allcallday/CS493_Autonomous_Robot_Car/CMPE 492 - Senior Design 1/Block Diagram.pptx

V REGULATOR 3.3 V

5V

Oscillator

PWMx2

Rst Button

SCL

Lvl Shifter

CPU

Analog (to ADC)

SDA

DC
motor

+

Imu

IR Sensor

Serial TXD

H-BRIDGE

Analog (to ADC)

LCD Toggle Button

Analog (to ADC)

IR Sensor

IR Sensor

ULTRASONIC
SENSOR x2

DC
motor

+

5V

V REGULATOR 5V

LCD CHARACTER DISPLAY

Trig

Echo
