allcallday/CS493_Autonomous_Robot_Car/Meeting Notes/MeetingNotes 4_10_2020.docx

4/10/2020

Meeting Notes

4/10/2020 Fri. 13:05

- meeting w/ prof.
- opening a serial port on Beaglebone
  - blah
- IR sensor testing considerations
  - know your ADC
    - does your microprocessor have one built in?
    - what’s the bit resolution?
    - how many separate analog signals can it convert at a time?
    - if your processor’s ADC has different specs than someone else’s, you will probably have different results and driver implementations
