allcallday/CS493_Autonomous_Robot_Car/Meeting Notes/MeetingNotes 4_24_2020.docx

4/24/2020

CMPE 493

Meeting Notes

4/24/2020 Fri. 13:00

- regular weekly meeting w/ prof.
- Group member progress:
  - Christian
    - got LCD module to work
  - Abdullah
    - modified PCB for further testing
    - may have found a way to use the custom PCB without having to remove the Atmel UC3C
  - Eric
    - got ultrasonic distance sensors working
    - IMU prep
      - Arduino uno needs level shifter hardware to communicate w/ IMU
      - began soldering connections to level shifter on PCB
- start bringing the peripherals together into a full system
