allcallday/CS493_Autonomous_Robot_Car/CMPE 492 - Senior Design 1/CPU Pin Connections.xlsx

TQFP 64. Pin Num. | Pin Name | Pin Function |  |  |  |  |  | Connected to Device: | Description
 |  | A | B | C | D | E | F
1 | PA00 | - | CANIF - TXLINE[1] | - | - | - | - | JTAG - TCK
2 | PA01 | - | CANIF - RXLINE[1] | PEVC - PAD_EVT[0] | - | - | - | JTAG - TDI
3 | PA02 | SCIF - GCLK[0] | - | PEVC - PAD_EVT[1] | - | - | - | JTAG - TDO
4 | PA03 | SCIF - GCLK[1] | EIC - EXTINT[1] | - | - | - | - | JTAG - TMS
5 | VDDIO1 | - | - | - | - | - | - | VDD_5
6 | GNDIO1 | - | - | - | - | - | - | GND
7 | PA04 | ADCIN0 | USBC - ID | ACIFA0 - ACAOUT | - | - | - | IR_1 - Col. | -
8 | PA05 | ADCIN1 | USBC - VBOP | ACIFA0 - ACBOUT | - | - | - | IR_2 - Col. | -
9 | PA06 | ADCIN2 | AC1AP1 | PEVC - PAD_EVT[2] | - | - | - | IR_3 - Col. | -
10 | PA07 | ADCIN3 | AC1AN1 | PEVC - PAD_EVT[3] | - | - | -
11 | PA08 | ADCIN4 | AC1BP1 | EIC - EXTINT[2] | - | - | - | GPIO - Button 1 | Toggle LCD
12 | PA09 | ADCIN5 | AC1BN1 | - | - | - | - | GPIO - Button 2 | Begin Log Export
13 | PA16 | ADCREF0 | - | DACREF | - | - | -
14 | ADCVREFP | - | - | - | - | - | - | VDD_5
15 | ADCVREFN | - | - | - | - | - | - | GND
16 | PA19 | ADCIN8 | EIC - EXTINT[1] | - | - | - | - | GND
17 | GNDANA | - | - | - | - | - | - | GND
18 | VDDANA | - | - | - | - | - | - | VDD_5
19 | PA20 | ADCIN9 | AC0AP0 |  | - | - | - | GND
20 | PA21 | ADCIN10 | AC0BN0 |  | - | - | - | GND
21 | PA22 | ADCIN11 | AC0AN0 |  | - | MACB - SPEED | -
22 | PA23 | ADCIN12 | AC0BP0 |  | - | MACB - WOL | -
23 | VBUS | - | - | - | - | - | - | NC
24 | DM | - | - | - | - | - | - | NC
25 | DP | - | - | - | - | - | - | NC
26 | GNDPLL | - | - | - | - | - | - | GND
27 | VDDIN_5 | - | - | - | - | - | - | VDD_5
28 | VDDIN_33 | - | - | - | - | - | - | NC
29 | VDDCORE | - | - | - | - | - | - | NC
30 | GNDCORE | - | - | - | - | - | - | GND
31 | PB30 | - | - | - | - | - | - | Crystal
32 | PB31 | - | - | - | - | - | - | Crystal
33 | PC02 | TWIMS0 - TWD | SPI0 - SPCS[3] | USART2 - RXD | TC1 - CLK1 | MACB - MDC |  | Lvl Shifter HV1 - IMU clk
34 | PC03 | TWIMS0 - TWCK | EIC - EXTINT[1] | USART2 - TXD | TC1 - B1 | MACB - MDIO |  | Lvl Shifter HV2 - IMU data
35 | VDDIO2 | - | - | - | - | - | - | VDD_5
36 | GNDIO2 | - | - | - | - | - | - | GND
37 | PC04 | TWIMS1 - TWD | EIC - EXTINT[3] | USART2 - TXD | TC0 - B1 | - | -
38 | PC05 | TWIMS1 - TWCK | EIC - EXTINT[4] | USART2 - RXD | TC0 - B2 | - | -
39 | PC15 | PWM - PWMH[1] | SPI0 - NPCS[0] | EBI - SDWE | USART0 - RXD | CANIF - RXLINE[1] | - | L293DD - En1
40 | PC16 | PWM - PWML[1] | SPI0 - NPCS[1] | EBI - CAS | USART0 - TXD | CANIF - TXLINE[1] | - | GPIO - L293DD - In1
41 | PC17 | PWM - PWMH[0] | SPI0 - NPCS[2] | EBI - RAS | IISC - ISDO | - | USART3 - TXD | GPIO - L293DD - In2
42 | PC18 | PWM - PWML[0] | EIC - EXTINT[5] | EBI - SDA10 | IISC - ISDI | - | USART3 - RXD | GPIO - L293DD - In3
43 | PC19 | PWM - PWML[2] | SCIF - GCLK[0] | EBI - DATA[0] | IISC - IMCK | - | USART3 - CTS | GPIO - L293DD - In4
44 | PC20 | PWM - PWMH[2] | SCIF - GCLK[1] | EBI - DATA[1] | IISC - ISCK | - | USART3 - RTS | L293DD - En2
45 | PC21 | PWM - EXT_FAULTS[0] | CANIF - RXLINE[0] | EBI - DATA[2] | IISC - IWS | - | -
46 | PC22 | PWM - EXT_FAULTS[1] | CANIF - TXLINE[0] | EBI - DATA[3] | - | USART3 - CLK | - | GPIO - Ultrasonic - EchoL
47 | PD00 | SPI0 - MOSI | TC1 - CLK0 | EBI - DATA[13] | QDEC0 - QEPI | USART0 - TXD | - | GPIO - Ultrasonic - EchoR
48 | PD01 | SPI0 - MISO | TC1 - A0 | EBI - DATA[14] | TC0 - CLK1 | USART0 - RXD | - | GPIO - Ultrasonic - Trig
49 | PD02 | SPI0 - SCK | TC0 - CLK2 | EBI - DATA[15] | QDEC0 - QEPA | - | -
50 | PD03 | SPI0 - NPCS[0] | TC0 - B2 | EBI - ADDR[0] | QDEC0 - QEPB | - | -
51 | VDDIO3 | - | - | - | - | - | - | VDD_5
52 | GNDIO3 | - | - | - | - | - | - | GND
53 | PD11 | USART1 - TXD | USBC - ID | EBI - ADDR[8] | PEVC - PAD_EVT[6] | MACB - TXD[0] | - | LogOut - TXD
54 | PD12 | USART1 - RXD | USBC - VBOF | EBI - ADDR[9] | PEVC - PAD_EVT[7] | MACB - TXD[1] | - | LogOut - RXD
55 | PD13 | USART1 - CTS | USART1 - CLK | EBI - SDCK | PEVC -PAD_EVT[8] | MACB - RXD[0] | - | LogOut - CTS
56 | PD14 | USART1 - RTS | EIC - EXTINT[7] | EBI - ADDR[10] | REVD - PAD_EVT [9] | MACB - RXD[1] | - | LogOut - RTS
57 | PD21 | USART3 - TXD | EIC - EXTINT[0] | EBI - ADDR[17] | QDEC1 - QEPA | - | - | LCD - Rx
58 | PD27 | USART0 - TXD | CANIF - RXLINE[0] | EBI - NCS[1] | TC0 - A0 | MACB - RX_ER | -
59 | PD28 | USART0 - RXD | CANIF - TXLINE[0] | EBI - NCS[2] | TC0 - A0 | MACB - RX_DV | -
60 | PD29 | USART0 - CTS | EIC - EXTINT[6] | USART0 - CLK | TC0 - CLK0 | MACB - TX_CLK | -
61 | PD30 | USART0 - RTS | EIC - EXTINT[3] | EBI - NWAIT | TC0 - A1 | MACB - TX_EN | -
62 | PB00 | USART0 - CLK | CANIF - RXLINE[1] | EIC - EXTINT[8] | PEVC - PAD_EVT[10] | - | -
63 | PB01 | - | CANIF - TXLINE[1] | - | PEVC - PAD_EVT[11] | - | -
64 | RESET_N | - | - | - | - | - | -
 |  |  |  |  | .
Disabled Connections: | Occupied Connections: | Free GPIO pins (14):
 | TWIMS0 | PA7
 | PWMH[1] | PA16
 | PWMH[2] | PA22
 | USART1 | PA23
 | USART3 | PC04
 |  | PC05
 |  | PC21
