allcallday/CS493_Autonomous_Robot_Car/CMPE 492 - Senior Design 1/Senior Design Group Meeting Schedule.xlsx

Senior Design Group Meeting Schedule |  |  |  | Online meeting | In-person meeting
Regular Meetings
Time | Mon. | Tue. | Wed. | Thurs. | Fri. | Sat. | Sun. | * [EF]: I have a phone appointment at 2:30pm on Tue. 11/5
8:00:00
9:00:00
10:00:00 |  | [AW] |  | [AW]
11:00:00 |  | [AW] |  | [AW] |  | [EF] [AW] [CA]
12:00:00 | [EF] | [AW] | [EF] | [AW] |  | [EF] [AW] [CA]
13:00:00 | [EF] | [EF] [AW] [CA] | [EF] | [EF] [AW] |  | [EF] [AW] [CA]
14:00:00 | [EF] [AW] [CA] | [EF] [AW] [CA] | [EF] [AW] [CA] | [EF] [AW] |  | [EF] [AW] [CA]
15:00:00 | [EF] [AW] [CA] | [EF] [AW] [CA] | [EF] [AW] [CA] | [EF] [AW] | [AW] | [EF] [AW] [CA]
16:00:00 | [EF] | [AW] | [EF] | [AW] | [AW] | [EF] [AW] [CA]
17:00:00 | [EF] | [AW] | [EF] | [AW] | [AW]
18:00:00 | [EF] | [AW] | [EF] | [AW] | [AW]
19:00:00 | [EF] | [EF] [AW] | [EF] | [EF] [AW] | [AW]
20:00:00 | [EF] | [EF] [AW] | [EF] | [EF] [AW] | [AW]
21:00:00
22:00:00
23:00:00
Nonregular Meetings
Date | Day | Time | Place
2019-11-02 | Sat. | 11:00:00 | SciN 237
