allcallday/CS493_Autonomous_Robot_Car/CMPE 492 - Senior Design 1/BoM/BoM-OtherMaterials.xlsx

IR Bumper BoM
Item # | *Ref Des | *Qty | Manufacturer | *Mfg Part # | Description / Value | *Package | Type | Your Instructions / Notes | Unit Cost | Total Cost | Website
1 | JP1 | 1 | Sullins Connector Solutions |  | Pin Header Male 5x1 0.1 inch | 1x05 | Thru-hole | -
2 | R1 | 1 | Yageo | RC0805JR-07100RL | Resistor 100Ohm | M0805 | SMD | - | 0.10000 | $0.10 | https://www.digikey.com/product-detail/en/yageo/RC0805JR-07100RL/311-100ARCT-ND/731185
3 | R2,R3,R4 | 10 | Yageo | RC0805FR-0710KL | Resistor 10KOhm | M0805 | SMD | - | 0.04000 | $0.40 | https://www.digikey.com/product-detail/en/yageo/RC0805FR-0710KL/311-10.0KCRCT-ND/730482
4 | U1,U2,U3 | 10 | ON Semiconductor | QRE1113GR | IR Reflective Sensor | 4-SMD | SMD | - | 0.84500 | $8.45 | https://www.digikey.com/product-detail/en/on-semiconductor/QRE1113GR/QRE1113GRCT-ND/965713
 |  |  |  |  |  |  |  |  |  | $8.95
Offboard Modules BoM
Item # | *Ref Des | *Qty | Manufacturer | *Mfg Part # | Description / Value | *Package | Type | Your Instructions / Notes | Unit Cost | Total Cost | Website
1 | - | 2 | Sparkfun Electronics | SEN-15569 | Ultrasonic Proximity Sensor | N/A | - | - | 3.95000 | $7.90 | https://www.digikey.com/products/en?keywords=SEN-15569
2 | - | 1 | Adafruit Industries LLC | 782 | LCD Module | N/A | - | - | 24.95000 | $24.95 | https://www.digikey.com/product-detail/en/adafruit-industries-llc/782/1528-2051-ND/5761275
3 | - | 5 | NMB Technologies Corporation | M1N10FB11G | DC Brushed Motor | N/A | - | - | 3.07800 | $15.39 | https://www.digikey.com/product-detail/en/nmb-technologies-corporation/M1N10FB11G/P14354-ND/2417078
4 | - | 1 | Microchip Technology | ATATMEL-ICE-BASIC | ATMEL ICE Basic Programmer | N/A | - | - | 90.89000 | $90.89 | https://www.digikey.com/product-detail/en/microchip-technology/ATATMEL-ICE-BASIC/ATATMEL-ICE-BASIC-ND/4753381
5 | - | 1 | Sabrent |  | USB to Serial Cable | N/A | - | - | 8.99000 | $8.99 | https://www.amazon.com/Sabrent-Converter-Prolific-Chipset-CB-DB9P/dp/B00IDSM6BW
6 | - | 1 | Bonatech |  | 2-wheel car chassis | N/A | - | - | 17.89000 | $17.89 | https://www.amazon.com/BONATECH-Tracking-Obstacle-Avoidance-Detailed/dp/B07DMCWRJ1
7 | - | 1 | LampVPath |  | 4-slot AA battery Holder | N/A | - | - | 5.99000 | $5.99 | https://www.amazon.com/LAMPVPATH-Battery-Holder-Leads-Wires/dp/B07T7MTRZX
8 | - | 1 | STIKK |  | Blue Painter Tape | N/A | - | - | 8.97000 | $8.97 | https://www.amazon.com/STIKK-Painters-Release-Finishing-Masking/dp/B01MYP8R5B
 |  |  |  |  |  |  |  |  | total | $180.97
