allcallday/CS493_Autonomous_Robot_Car/CMPE 492 - Senior Design 1/Milestone Submissions/Milestone 3 - Bill of Materials.xlsx

Quantity: | Manufacturer: | Part Number: | URL: | Unit Price: | Ext. Price: | Description: | Power Requirements: | Digikey Part No.: | Datasheet: | Connectivity: | Has EAGLE Part:
1 | Microchip Technology | ATATMEL-ICE-BASIC | https://www.digikey.com/product-detail/en/microchip-technology/ATATMEL-ICE-BASIC/ATATMEL-ICE-BASIC-ND/4753381 | 90.88900 | $90.89 | Atmel-ICE basic JTAG programmer | N/A | ATATMEL-ICE-BASIC-ND | http://ww1.microchip.com/downloads/en/DeviceDoc/Atmel-ICE_UserGuide.pdf | 2x5 50-mil male pin header | N/A | $209.93
5 | NMB Technologies Corporation | M1N10FB11G | https://www.digikey.com/product-detail/en/nmb-technologies-corporation/M1N10FB11G/P14354-ND/2417078 | 3.25000 | $15.54 | DC brushless motor | 5V DC | P14354-ND | https://media.digikey.com/pdf/Data%20Sheets/NMB-MAT/M1N10.pdf | N/A | Represent w/ pads
2 | SparkFun Electronics | SEN-15569 | https://www.digikey.com/products/en?keywords=SEN-15569 | 3.95000 | $7.90 | Ultrasonic distance sensor | 5V | 1568-SEN-15569-ND | https://cdn.sparkfun.com/datasheets/Sensors/Proximity/HCSR04.pdf | Trig-Echo - 2 | Y
10 | ON Semiconductor | QRE1113GR | https://www.digikey.com/product-detail/en/on-semiconductor/QRE1113GR/QRE1113GRCT-ND/965713 | 1.09000 | $8.45 | IR reflective sensor | 5 V | QRE1113GRCT-ND | https://www.onsemi.com/pub/Collateral/QRE1113-D.PDF | Analog - 3 | Y
1 | STMicroelectronics | L293DD | https://www.digikey.com/product-detail/en/stmicroelectronics/L293DD/497-1390-5-ND/585913 | 3.91000 | $3.91 | H-bridge (surface mount) | 4.5V - 36V | 497-1390-5-ND | https://www.st.com/content/ccc/resource/technical/document/datasheet/04/ac/22/f9/20/5d/43/a1/CD00000059.pdf/files/CD00000059.pdf/jcr:content/translations/en.C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 | PWM - 1 | Y
10 | C&K | PTS645SM43SMTR92 LFS | https://www.digikey.com/product-detail/en/c-k/PTS645SM43SMTR92-LFS/CKN9112CT-ND/1146934 | 0.31000 | $3.00 | push buttons | N/A | CKN9112CT-ND | https://www.digikey.com/en/datasheets/ck/ckpts645 | N/A | Y
10 | Diodes Incorporated | AP2210K-5.0TRG1 | https://www.digikey.com/product-detail/en/diodes-incorporated/AP2210K-5.0TRG1/AP2210K-5.0TRG1DICT-ND/4505292 | 0.42000 | $3.49 | voltage regulators (output 5V) | max: 13.2V | AP2210K-5.0TRG1DICT-ND | https://www.diodes.com/assets/Datasheets/AP2210.pdf | N/A | Y
1 | Microchip Technologies | AT32UC3C2512C-A2UT | https://www.digikey.com/product-detail/en/microchip-technology/AT32UC3C2512C-A2UT/AT32UC3C2512C-A2UT-ND/2507920 | 10.64000 | $10.64 | 32-bit AVR CPU | 3V ~ 5.5V | AT32UC3C2512C-A2UT-ND | http://ww1.microchip.com/downloads/en/DeviceDoc/doc32117.pdf | PWM - 1, USART - 5, SPI - 2, I2C - 3 | Y
1 | Adafruit Industries LLC | 782 | https://www.digikey.com/product-detail/en/adafruit-industries-llc/782/1528-2051-ND/5761275 | 24.95000 | $24.95 | LCD Character display | 5V | 1528-2051-ND | https://cdn-learn.adafruit.com/downloads/pdf/usb-plus-serial-backpack.pdf | Serial | Y
1 | SparkFun Electronics | SEN-13762 | https://www.digikey.com/product-detail/en/sparkfun-electronics/SEN-13762/1568-1420-ND/6166011 | 14.95000 | $14.95 | imu module for accelerometer | 2.4V ~ 3.6V | 1568-1420-ND | https://www.invensense.com/wp-content/uploads/2015/02/MPU-9250-Datasheet.pdf | I2C - 1 | Y
1 | IQD Frequency Products | LFXTAL003210BULK | https://www.digikey.com/product-detail/en/iqd-frequency-products/LFXTAL003210BULK/1923-1459-ND/8633747 | 0.59000 | $0.59 | 12 MHz crystal oscillator | N/A | 1923-1459-ND | https://www.iqdfrequencyproducts.com/products/pn/LFXTAL003210Bulk.pdf | N/A | Y
10 | Diodes Incorporated | AP2210K-3.3TRG1 | https://www.digikey.com/product-detail/en/diodes-incorporated/AP2210K-3.3TRG1/AP2210K-3.3TRG1DICT-ND/4505291 | 0.31000 | $3.10 | voltage regulator 3.3V | max: 13.2 V | AP2210K-5.0TRG1DICT-ND | https://www.diodes.com/assets/Datasheets/AP2210.pdf | N/A | Y
10 orders, 23 pins total | Adam Tech | PH1-04-UA | https://www.digikey.com/product-detail/en/adam-tech/PH1-04-UA/2057-PH1-04-UA-ND/9829296 | 0.07300 | $0.73 | male 4-pin header (UART - 2, motors - 4, ultrasonics - 8, IRs - 7, IMU - 4, LCDDisplay - ?, JTAG interface) | N/A | 2057-PH1-04-UA-ND | http://adam-tech.com/downloader.php?p=PH1-XX-UA.pdf | N/A | Generics in EAGLE
10 | Sullins Connector Solutions | NPPN041BFLC-RC | https://www.digikey.com/product-detail/en/sullins-connector-solutions/NPPN041BFLC-RC/S5901-04-ND/807246 | 0.66000 | $6.68 | 4x1 rectangular female header | N/A | S5901-04-ND | https://drawings-pdf.s3.amazonaws.com/10489.pdf | N/A | Generics in EAGLE
10 | Sullins Connector Solutions | NPPN051BFLD-RC | https://www.digikey.com/product-detail/en/sullins-connector-solutions/NPPN051BFLD-RC/S5902-05-ND/810021 | 0.78000 | $7.80 | 5x1 rectangular female header | N/A | S5902-05-ND | https://drawings-pdf.s3.amazonaws.com/10489.pdf | N/A | Generics in EAGLE
1 | Sullins Connector Solutions | GRPB052VWQP-RC | https://www.digikey.com/product-detail/en/sullins-connector-solutions/GRPB052VWQP-RC/S9013E-05-ND/1786428 | 1.05000 | $1.05 | 2x5 male pin header (1.27mm spacing) for jtag SMD | N/A | 609-3695-1-ND | https://s3.amazonaws.com/catalogspreads-pdf/PAGE94-95%20.050%20MALE%20HDR%20ST%20RA%20SMT.pdf |  | Y
10 | ON Semiconductor | BSS138 | https://www.digikey.com/product-detail/en/on-semiconductor/BSS138/BSS138CT-ND/244294 | 0.22000 | $2.20 | N-channel MOSFET for level shifting | source-gate: 3.3V, drain: 5V | BSS138CT-ND | https://www.onsemi.com/pub/Collateral/BSS138-D.PDF | N/A | Y
1 | Nidec Copal Electronics | AS1E-2M-10-Z | https://www.digikey.com/product-detail/en/nidec-copal-electronics/AS1E-2M-10-Z/563-1582-ND/1792120 | 2.27000 | $2.27 | slide switch for power |  | 563-1582-ND | https://www.nidec-copal-electronics.com/e/catalog/switch/as.pdf | N/A | Y
10 | Yageo | RC0805JR-07100RL | https://www.digikey.com/product-detail/en/yageo/RC0805JR-07100RL/311-100ARCT-ND/731185 | 0.03500 | $0.35 | 100 Ohm | 0.063W, 1/16W | 311-100ARCT-ND | https://www.yageo.com/upload/media/product/productsearch/datasheet/rchip/PYu-RC_Group_51_RoHS_L_10.pdf | N/A | Y
4 | Yageo | RC0805FR-0710KL | https://www.digikey.com/product-detail/en/yageo/RC0805FR-0710KL/311-10.0KCRCT-ND/730482 | 0.10000 | $0.40 | 10 KOhm |  | 311-10.0KCRCT-ND | https://www.yageo.com/upload/media/product/productsearch/datasheet/rchip/PYu-RC_Group_51_RoHS_L_10.pdf | -
2 | Kemet | C0805C101JAGAC7800 | https://www.digikey.com/product-detail/en/kemet/C0805C101JAGAC7800/399-15000-1-ND/7382549 | 0.93000 | $1.86 | 100 pF Capacitor |  | 399-15000-1-ND | https://content.kemet.com/datasheets/KEM_C1003_C0G_SMD.pdf | -
2 | Kemet | 399-4925-1-ND | https://www.digikey.com/product-detail/en/kemet/C0805C106K8PACTU/399-4925-1-ND/1090920 | 0.16000 | $0.32 | 10 uF Capacitor |  | 399-4925-1-ND | https://www.digikey.com/product-detail/en/kemet/C0805C106K8PACTU/399-4925-1-ND/1090920 | -
1 | Sabrent | DP9P-9P6F | https://www.amazon.com/Sabrent-Converter-Prolific-Chipset-CB-DB9P/dp/B00IDSM6BW | 8.99000 | $8.99 | USB to serial cable
1 | eBoot | EBOOT-BULBS-03 | https://www.amazon.com/eBoot-Pieces-Emitting-Diodes-Assorted/dp/B06XPV4CSH | 6.55000 | $6.55 | LEDs |  | N/A | N/A | N/A | Generics in EAGLE
1 | Bonatech | N/A | https://www.amazon.com/BONATECH-Tracking-Obstacle-Avoidance-Detailed/dp/B07DMCWRJ1 | 17.89000 | $17.89 | 2-wheel car chasis | N/A | N/A | N/A | N/A | N/A
1 | LAMPVPATH | 4AA-2PC | https://www.amazon.com/LAMPVPATH-Battery-Holder-Leads-Wires/dp/B07T7MTRZX | 5.99000 | $5.99 | (Pack of 2) 4 AA battery holder | 4 AA batteries = 6V | N/A | N/A | N/A | N/A
1 | STICK | N/A | https://www.amazon.com/STIKK-Painters-Release-Finishing-Masking/dp/B01MYP8R5B | 8.97000 | $8.97 | Blue Painter Tape | N/A | N/A | N/A | N/A | N/A
Old Parts:
~~1~~ | ~~SparkFun Electronics~~ | ~~PGM-09825 ~~ | ~~https://www.digikey.com/products/en?keywords=pocket%20avr%20programmer~~ |  | ~~$16.95~~ | ~~POCKET AVR PROGRAMMER~~ |  | ~~1568-1080-ND~~ | ~~https://media.digikey.com/pdf/Data%20Sheets/Sparkfun%20PDFs/Pocket_AVR_Prog_HookupGuide_Web.pdf~~ | ~~SPI~~
~~1~~ | ~~SparkFun Electronics~~ | ~~DEV-09215~~ | ~~https://www.digikey.com/product-detail/en/sparkfun-electronics/DEV-09215/1568-1361-ND/5973887~~ |  | ~~$1.95~~ | ~~AVR programming cable~~ |  | ~~1568-1361-ND~~ | ~~https://media.digikey.com/pdf/Data%20Sheets/Sparkfun%20PDFs/DEV-09215_Web.pdf~~ | ~~SPI~~
~~1~~ | ~~Microchip Technology~~ | ~~ATMEGA328P-AU~~ | ~~https://www.digikey.com/product-detail/en/microchip-technology/ATMEGA328P-AU/ATMEGA328P-AU-ND/1832260~~ |  | ~~$2.07~~ | ~~cpu~~ | ~~1.8V - 5.5V~~ | ~~ATMEGA328P-AU-ND~~ |  | ~~I²C, SPI, UART/USART~~
~~5~~ | ~~Kionix Inc.~~ | ~~KXTJ3-1057~~ | ~~https://www.digikey.com/product-detail/en/kionix-inc/KXTJ3-1057/KXTJ3-1057CT-ND/6573089~~ |  | ~~$8.14~~ | ~~accelerometer~~ | ~~1.71V –3.6V~~ |  |  | ~~I2C~~
~~1~~ | ~~Lumex Opto/Components Inc.~~ | ~~LCM-S01602DTR/M~~ | ~~https://www.digikey.com/product-detail/en/lumex-opto-components-inc/LCM-S01602DTR-M/67-1781-ND/469805~~ |  | ~~$9.65~~ | ~~LCD Character display~~ | ~~5V~~ | ~~67-1781-ND~~ |  | ~~parallel?~~
~~1~~ | ~~Newhaven Display Intl~~ | ~~NHD-C0216AZ-FSW-GBW-ND~~ | ~~https://www.digikey.com/product-detail/en/newhaven-display-intl/NHD-C0216AZ-FSW-GBW/NHD-C0216AZ-FSW-GBW-ND/2165869~~ |  | ~~$10.72~~ | ~~LCD Character display~~ | ~~4.7V ~ 5.5V~~ | ~~NHD-C0216AZ-FSW-GBW-ND~~ | ~~http://www.newhavendisplay.com/specs/NHD-C0216AZ-FSW-GBW.pdf~~ | ~~parallel~~
~~1~~ | ~~Diodes Incorporated ~~ | ~~AP2210N-5.0TRG1DICT-ND~~ | ~~https://www.digikey.com/product-detail/en/diodes-incorporated/AP2210N-5.0TRG1/AP2210N-5.0TRG1DICT-ND/8283839~~ |  |  | ~~Power regulator (linear regulartor was receommended)~~ | ~~5V ~ 13.2V~~ | ~~AP2210N-5.0TRG1DICT-ND~~ | ~~https://www.diodes.com/assets/Datasheets/AP2210.pdf~~ |  | ~~N~~
~~1~~ | ~~Interquip Electronics (Shenzhen) Co.~~ | ~~7C16000183AKAF40Q5~~ | ~~https://www.adafruit.com/product/2215~~ |  | ~~$0.75~~ | ~~16 MHz crystal oscillator~~ |  | ~~N/A~~ | ~~https://cdn-shop.adafruit.com/product-files/2215/2215datasheet.pdf~~ |  | ~~pretty sure in default eagle library~~
~~1~~ | ~~SparkFun Electronics~~ | ~~BOB-12009 ~~ | ~~https://www.digikey.com/products/en?keywords=%20BOB-12009~~ | ~~$2.95~~ | ~~$2.95~~ | ~~i2c level shifter (used for imu module)~~ | ~~step up/down 3.3V - 5V~~ | ~~1568-1209-ND~~ | ~~https://www.onsemi.com/pub/Collateral/BSS138-D.PDF~~ | ~~N/A~~ | ~~Y~~
~~10~~ | ~~Texas Instruments~~ | ~~CD40109BPWR~~ | ~~https://www.digikey.com/product-detail/en/texas-instruments/CD40109BPWR/296-12163-1-ND/412005~~ | ~~$0.37~~ | ~~$3.71~~ | ~~voltage level shifter~~ | ~~3V ~ 18V~~ | ~~296-12163-1-ND~~ | ~~http://www.ti.com/lit/ds/symlink/cd40109b.pdf~~ | ~~N/A~~ | ~~Y~~
~~1~~ | ~~Texas Instruments~~ | ~~ADS7816U~~ | ~~https://www.digikey.com/product-detail/en/texas-instruments/ADS7816U/296-44996-5-ND/254631~~ | ~~$6.54~~ | ~~$6.54~~ | ~~12-bit ADC~~ | ~~5V~~ | ~~296-44996-5-ND~~ | ~~http://www.ti.com/general/docs/suppproductinfo.tsp?distId=10 | ~~SPI~~ | ~~Y~~
1 | ~~Duck~~ | ~~299006~~ | ~~https://www.amazon.com/Duck-299006-Utility-Electrical-Single/dp/B001B19JLS | ~~$4.73~~ | ~~$4.73~~ | ~~electrical tape to create path~~ | ~~N/A~~ | ~~N/A~~ | ~~N/A~~ | ~~N/A~~ | ~~N/A~~
~~3~~ | ~~Yageo~~ | ~~CF14JT10K0CT-ND~~ | ~~https://www.digikey.com/product-detail/en/yageo/RC0805FR-0710KL/311-10.0KCRCT-ND/730482~~ | ~~$0.10~~ | ~~$0.30~~ | ~~10k Resistor~~ | ~~0.125W, 1/8W~~ | ~~311-10.0KCRCT-ND~~ | ~~https://www.yageo.com/upload/media/product/productsearch/datasheet/rchip/PYu-RC_Group_51_RoHS_L_10.pdf~~ | ~~N/A~~ | ~~Y~~
~~1~~ | ~~Yageo~~ | ~~RC0402FR-0710RL~~ | ~~https://www.digikey.com/product-detail/en/yageo/RC0402FR-0710RL/311-10.0LRCT-ND/729471~~ | ~~$0.10~~ | ~~$0.10~~ | ~~10 Ohm~~ | ~~0.063W, 1/16W~~ | ~~311-10.0LRCT-ND~~ | ~~https://www.yageo.com/upload/media/product/productsearch/datasheet/rchip/PYu-RC_Group_51_RoHS_L_10.pdf~~ | ~~N/A~~ | ~~Y~~
~~2~~ | ~~Murata Electronics~~ | ~~GRM0335C1H100JA01J~~ | ~~https://www.digikey.com/product-detail/en/murata-electronics/GRM0335C1H100JA01J/490-17811-1-ND/8540047~~ | ~~$0.10~~ | ~~$0.20~~ | ~~10pF~~ |  | 490-17811-1-ND | https://www.digikey.com/product-detail/en/murata-electronics/GRM0335C1H100JA01J/490-17811-1-ND/8540047
~~1~~ | ~~Murata Electronics~~ | ~~GRM033R61A104ME15D~~ | ~~https://www.digikey.com/product-detail/en/murata-electronics/GRM033R61A104ME15D/490-5405-1-ND/2175212~~ | ~~$0.10~~ | ~~$0.10~~ | ~~0.1 uF Capacitor~~ |  | 490-5405-1-ND
~~1~~ | ~~SparkFun Electronics~~ | ~~PRT-00449~~ | ~~https://www.digikey.com/products/en?keywords=SparkFun%20RS232%20Shifter~~ | ~~15.95000~~ | ~~$15.95~~ | ~~RS232 Shifter~~ |  | ~~1568-1283-ND~~ | ~~https://github.com/sparkfun/RS232_Shifter_SMD/tree/V_1.5~~ | ~~N/A~~
https://www.amazon.com/Sabrent-Converter-Prolific-Chipset-CB-DB9P/dp/B00IDSM6BW
https://www.sparkfun.com/products/449
