allcallday/CS493_Autonomous_Robot_Car/CMPE 492 - Senior Design 1/Processor Stuff.xlsx

 | Core Size | Package/Case | Interfaces/Connectivity | Peripherals | Integrated Circuit Type | Data Memory (rough estimate) | Voltage
Criteria: | 32+ bits | surface mount, not-BGA, not-QFN | I^2C, SPI, UART/USART | PWM | Embedded - Microcontroller (not microprocessor) | 35 KB | 5 V (lower is allowable, but more effort)
Eric's searches |  | Search Parameters | https://www.digikey.com/products/en/integrated-circuits-ics/embedded-microcontrollers/685
Manufacturer: | Part Number: | URL: | Price: | Description: | Power Requirements: | Digikey Part No.: | Datasheet: | Connectivity:
 | S9S12ZVL32F0VLF | https://www.digikey.com/product-detail/en/nxp-usa-inc/S9S12ZVL32F0VLF/568-14168-ND/5155467
 |  | https://www.digikey.com/product-detail/en/stmicroelectronics/STM32F030K6T6TR/497-17334-1-ND/7650388
Christian's searches
Manufacturer: | Part Number: | URL: | Price: | Description: | Power Requirements: | Digikey Part No.: | Datasheet: | Connectivity:
Microchip Technologies | AT91SAM7S64C-AU | https://www.digikey.com/product-detail/en/microchip-technology/AT91SAM7S64C-AU/AT91SAM7S64C-AU-ND/1994646 | $5.70 | ARM7 16/32bit processor | 1.65V ~ 1.95V | AT91SAM7S64C-AU-ND | AT91SAM7S64C-AU-ND | I²C, SPI, SSC, UART/USART, USB, PWM
STMicroelectronics | STM32L051C8T6TR | https://www.digikey.com/product-detail/en/stmicroelectronics/STM32L051C8T6TR/497-17487-6-ND/8024145 | $3.60 | ARM Cortex M0 32-bit processor | 1.65V ~ 3.6V | 497-17487-6-ND |  | I²C, IrDA, SPI, UART/USART
Microchip Technologies | AT32UC3C2512C-A2UT | https://www.digikey.com/product-detail/en/microchip-technology/AT32UC3C2512C-A2UT/AT32UC3C2512C-A2UT-ND/2507920 | $10.96 | 32-bit AVR | 3V ~ 5.5V | AT32UC3C2512C-A2UT-ND | http://ww1.microchip.com/downloads/en/DeviceDoc/doc32117.pdf
Abdullah's searches
Manufacturer: | Part Number: | URL: | Price: | Description: | Power Requirements: | Mouser No.: | Datasheet: | Connectivity:
Microchip Technologies | 579-MX130F256DIPT | https://www.mouser.com/ProductDetail/Microchip-Technology/PIC32MX130F256D-I-PT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 | $3.10 | 32-bit Microcontrollers - MCU 32-BIT MCU 256KB FL 16KB RAM, 10-BIT ADC | 2.3 V to 3.6 V | 579-MX130F256DIPT | PIC32MX130F256D-I/PT Datasheet (https://www.mouser.com/datasheet/2/268/60001168J-967542.pdf) | I2C, JTAG, PMP, SPI, UART
Texas Instruments | 595-TMS320F28027PTT | https://www.mouser.com/ProductDetail/Texas-Instruments/TMS320F28027PTT?qs=AFkNxQkJKALB%252BQv0Kl0bQA%3D%3D | $6.51 | 32-bit Microcontrollers - MCU Piccolo Microcntrlr |  | 595-TMS320F28027PTT | TMS320F28027PTT Datasheet (http://www.ti.com/general/docs/suppproductinfo.tsp?distId=26) | I2C, SCI, SPI
