allcallday/CS493_Autonomous_Robot_Car/CMPE 492 - Senior Design 1/BoM/AutoCarBoM-E.xlsx

Item # | *Ref Des | *Qty | Manufacturer | *Mfg Part # | Description / Value | *Package | Type | Your Instructions / Notes | Unit Cost | Total Cost | Website
1 | C3,C4 | 2 | Murata Electronics | C-USC0805 (C-US) (Version 44) | Capacitor 100uF | C0805 | SMD | - | 0.10000 | $0.20 | https://www.digikey.com/product-detail/en/kemet/C0805C101JAGAC7800/399-15000-1-ND/7382549
2 | C5,C6 | 2 | Kemet | 399-4925-1-ND | Capacitor 10uF | C0805 | SMD | - | 0.10000 | $0.20 | https://www.digikey.com/product-detail/en/kemet/C0805C106K8PACTU/399-4925-1-ND/1090920
3 | JP1 | 1 | TE Connectivity AMP Connectors | 3-644456-3 | Pin Header Male 3x1 0.1 inch | 1x03 | Thru-hole | - | 0.27000 | $0.27 | https://www.digikey.com/product-detail/en/te-connectivity-amp-connectors/3-644456-3/A31113-ND/698345
4 | JP3,JP5 | 2 | TE Connectivity AMP Connectors | 3-644456-5 | Pin Header Male 5x1 0.1 inch | 1x05 | Thru-hole | - | 0.40000 | $0.40 | https://www.digikey.com/product-detail/en/te-connectivity-amp-connectors/3-644456-5/A31115-ND/698347
5 | JP9, U3 (x2) | 3 | Adam Tech | PH1-04-UA | Pin Header Male 4x1 0.1 inch | 1x04 | Thru-hole | Use two of these to attach part U3 | 0.10000 | $0.30 | https://www.digikey.com/product-detail/en/adam-tech/PH1-04-UA/2057-PH1-04-UA-ND/9829296
6 | R5,R6,R7 | 3 | Yageo | RC0805JR-07100RL | Resistor 100Ohm | M0805 | SMD | - | 0.10000 | $0.30 | https://www.digikey.com/product-detail/en/yageo/RC0805JR-07100RL/311-100ARCT-ND/731185
7 | R8,R9,R10,R11 | 4 | Yageo | RC0805FR-0710KL | Resistor 10kOhm | M0805 | SMD | - | 0.10000 | $0.40 | https://www.digikey.com/product-detail/en/yageo/RC0805FR-0710KL/311-10.0KCRCT-ND/730482
8 | U4 | 1 | Nidec Copal Electronics | AS1E-2M-10-Z | Slide Switch | 1E-2M-10-Z | Thru-hole | - | 2.27000 | $2.27 | https://www.digikey.com/product-detail/en/nidec-copal-electronics/AS1E-2M-10-Z/563-1582-ND/1792120
9 | U1 | 1 | Microchip Technologies | AT32UC3C2512C-A2UT | AVR CPU | TQFP-64 | SMD | - | 10.64000 | $10.64 | https://www.digikey.com/product-detail/en/microchip-technology/AT32UC3C2512C-A2UT/AT32UC3C2512C-A2UT-ND/2507920
10 | U2 | 1 | Sullins Connector Solutions | GRPB052VWQP-RC | Pin Header Male 5x2 0.1 inch | VWQS5x2 | Thru-hole | - | 1.05000 | $1.05 | https://www.digikey.com/product-detail/en/sullins-connector-solutions/GRPB052VWQP-RC/S9013E-05-ND/1786428
11 | U7 | 1 | Diodes Incorporated | AP2210K-5.0TRG1 | Voltage Regulator 5V | SC-74A | SMD | - | 0.42000 | $0.42 | https://www.digikey.com/product-detail/en/diodes-incorporated/AP2210K-5.0TRG1/AP2210K-5.0TRG1DICT-ND/4505292
12 | U10 | 1 | Diodes Incorporated | AP2210K-3.3TRG1 | Voltage Regulator 3.3V | SC-74A | SMD | - | 0.41000 | $0.41 | https://www.digikey.com/product-detail/en/diodes-incorporated/AP2210K-3.3TRG1/AP2210K-3.3TRG1DICT-ND/4505291
13 | U12 | 1 | STMicroelectronics | L293DD | L293DD H-Bridge | SOIC20 | SMD | - | 4.22000 | $4.22 | https://www.digikey.com/product-detail/en/stmicroelectronics/L293DD/497-1390-5-ND/585913
14 | U14 | 1 | IQD Frequency Products | LFXTAL003210BULK | Crystal 32.768kHz 100ppm 12.5pF | HC-49/US | SMD | - | 0.59000 | $0.59 | https://www.digikey.com/product-detail/en/iqd-frequency-products/LFXTAL003210BULK/1923-1459-ND/8633747
15 | U17,U18 | 2 | C&K | PTS645SM43SMTR92 LFS | Push Button | SM43SMTR92LFS | SMD | - | 0.31000 | $0.62 | https://www.digikey.com/product-detail/en/c-k/PTS645SM43SMTR92-LFS/CKN9112CT-ND/1146934
16 | U19,U20 | 2 | ON Semiconductor | BSS138 | N Channel Transistor | SOT23 | SMD | - | 0.27000 | $0.54 | https://www.digikey.com/product-detail/en/on-semiconductor/BSS138/BSS138CT-ND/244294
17 | U3 | 1 | Sparkfun Electronics | SEN-13762 | IMU module | N/A | Thru-hole | Attach to board by standing off w/ two 4x1 pinheaders soldered at each end | 14.95000 | $14.95 | https://www.digikey.com/product-detail/en/sparkfun-electronics/SEN-13762/1568-1420-ND/6166011
 |  |  |  |  |  |  |  |  |  | $37.78
