allcallday/CS493_Autonomous_Robot_Car/Board Changelog.xlsx

Date | Time | Board ID | Worker | Parts | Location | Old Issues | Mod Description | New Issues
2-30-2020 | 18:00:00 | AA | John Doe | U3, R6, R7 | SciN 227 | IC U3 isn't drawing enough current; R6 resistance is too high | soldered R7 in parallel to R6 to decrease resistance and increase current | IC U3 output is too high for U7 | ← sample entry
2020-02-04 | 11:00:00 | All | Eric Fong | - | SciN 227 | PCB delivery delayed | PCB and circuit component delivery received; currently held at Eric's house | Get combo lock to claim a drawer in SciN 227; Main boards are mostly assembled; IR Bumper boards require assembly
2020-02-07 | 12:15:00 | All | All | assembled main boards, unassembled IR Bumper boards, IMUs | SciN 227 | - | Materials stored in SciN 227 drawer 19; combo: 16 6 20 | -
↑ | 13:19:00 | 1 | Christian Alcalde | board 1 | SciN 227 | boards not marked w/ IDs | scratched a '1' into surface of board 1 | -
2020-02-14 | 14:30:00 | 1 | Eric Fong | board 1 | SciN 227 | difficulty doing power-up testing by connecting directly to battery VSS-GND vias | soldered a couple jumper wires to the battery VSS-GND vias to clip onto | -
↑ | 14:30:00 | N/A | Christian Alcalde | Chassis | SciN 227 | - | assembled part of the chassis | missing several screws and nuts
↑ | 14:48:00 | 1 | Eric Fong, Abdullah Wardak | board 1 | SciN 227 | conducting power-up testing | supply power w/ voltage limit 5.9 VDC, slowly ramp up current limit from 0 until 5.9 V reached | At 5.9 VDC no-reset, the board draws 0.10 Amps, 0.59 W; w/ reset current drops to 0.05 A, 0.245 W
2020-02-21 | 13:00:00 | 1 | Christian Alcalde, Abdullah Wardak | board 1 | SciN 227 | conducting power-up testing | expected a current of 20 mA | not getting the expected current, got 60 mA
↑ | 14:41:00 | 1 | Christian Alcalde, Abdullah Wardak | board 1 | SciN 227 | checking to see where extra power is going, possibly at the H-bridge | using a multimeter, placed on ground and output 1, got ~10mV | need to test more voltages
2020-02-27 | 13:39:00 | N/A | Eric Fong | R1, R2, R3, R4, U1, U2, U3, ultrasonic, LCD, Atmel ICE Basic | SciN 227 | Missing parts for IR bumper and offboard modules | Received parts listed in Parts col. from Rechargabowl group | Need to check whether or not Tandon has our motors or if we need to purchase them again
2020-02-28 | 13:00:00 | N/A | All | Atmel-ICE | SciN 227 | Need IDE installed on computer | Installed Atmel Studio 7 and programmer drivers on computer 20 | Figure out how to work the IDE
↑ | 14:05:00 | N/A | Eric Fong | Atmel-ICE | SciN 227 | Testing female 10-pin connector for orientation with our board | Hooked up wires to individual pins and testing voltages with oscilloscope | wires used were too thick, need thinner wires
↑ | 14:30:00 | N/A | Abdullah Wardak | Chassis | SciN 227 | Taking home chassis for the weekend, will purchase screws and nuts | - | -
↑ | 14:36:00 | N/A | Eric Fong | Atmel-ICE | SciN 227 | Unknown orientation for connecting the programmer | 6-pin female connector should be dangling toward the gpio buttons, left and middle LED's on programmer should be on | -
2020-03-06 | 12:45:00 | N/A | Eric Fong | M1N10FB11G | SciN 227 | motors were not included in previous parts deliveries | checked packing list in shipment | these parts are backordered on Digikey
↑ | 14:30:00 | 1 | Eric Fong | board 1 | SciN 227 | attempted to program board | error message saying the board was actually a different chip | have to set the chip model as the uc30512c variant
2020-03-10 | 13:12:00 | 2 | ↑ | board 2, programmer 2 | SciN 227, EHome | - | Eric took board 2 and second programmer home to work on programming the CPU | -
2020-03-11 | 17:14:00 | 2 | Eric Fong | board 2 | EHome | board 2 had no leads for powering up | soldered wires to power terminals of board 2 | will need to unsolder the test leads to attach the battery holder
↑ | 17:53:00 | ↑ | ↑ | ↑ | ↑ | board 2 not labeled | scratched a '2' into surface of board 2 | -
↑ | 19:27:00 | ↑ | ↑ | ↑ | ↑ | board 2 not yet power-up tested | powered board 2 with a constant voltage power supply at 6.01 V | At 6.01 VDC no-reset, the 5V regulator outputs ~4.5 V; nothing burnt after 20 min of testing; Atmel ICE shows 'device power on' when plugged into JTAG pin header
2020-03-13 | 13:35:00 | 1 | Eric Fong | board 1 | SciN 227 | jtag reset pin not connected to processor's reset pin | soldered the reset switch's connection to the jtag reset pin | Reset switch MUST NOT be flipped to GND position (towards JP1); Atmel Studio 7 still displays the same error messages
2020-03-15 | 15:43:00 | 1 | Eric Fong | board 1, IMU module | EHome | IMU module not connected to board 1 | soldered IMU to board 1 | -
2020-03-16 | 17:25:00 | N/A | Eric Fong | LCD Module | EHome | LCD Module not assembled | soldered TTL serial backpack to LCD display | -
↑ |  |  |  |  | SciN 227 | - |  | -
↑ |  |  |  |  | SciN 227 | - |  | -
↑ |  |  |  |  | SciN 227 | - |  | -
↑ |  |  |  |  | SciN 227 | - |  | -
↑ |  |  |  |  | SciN 227 | - |  | -
↑
↑
↑
↑
↑
↑
↑
↑
↑
↑
↑
↑
↑
