allcallday/CS493_Autonomous_Robot_Car/CMPE 492 - Senior Design 1/MS4_Sch-Brd-PCB/IRBumper_AB.brd

## EAGLE design CMPE 492 - Senior Design 1/MS4_Sch-Brd-PCB/IRBumper_AB.brd (2021-09-21)

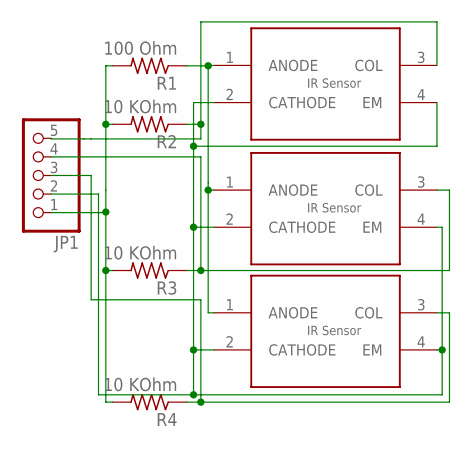
[picture p72: schematic IRBumper_AB.sch]

Parts:
JP1: PINHD-1X5; 1X05
R1: 100 Ohm; M0805
R2, R3, R4: 10 KOhm; M0805
U$1, U$2, U$3: QRE1113GR; 4-SMD

Connections:
GND: JP1.2, U$1.2 (CATHODE), U$1.4 (EM), U$2.2 (CATHODE), U$2.4 (EM), U$3.2 (CATHODE), U$3.4 (EM)
unnamed: R1.1, U$1.1 (ANODE), U$2.1 (ANODE), U$3.1 (ANODE)
unnamed: JP1.5, R2.1, U$2.3 (COL)
unnamed: JP1.4, R3.1, U$1.3 (COL)
unnamed: JP1.3, R4.1, U$3.3 (COL)
VDD_5: JP1.1, R1.2, R2.2, R3.2, R4.2

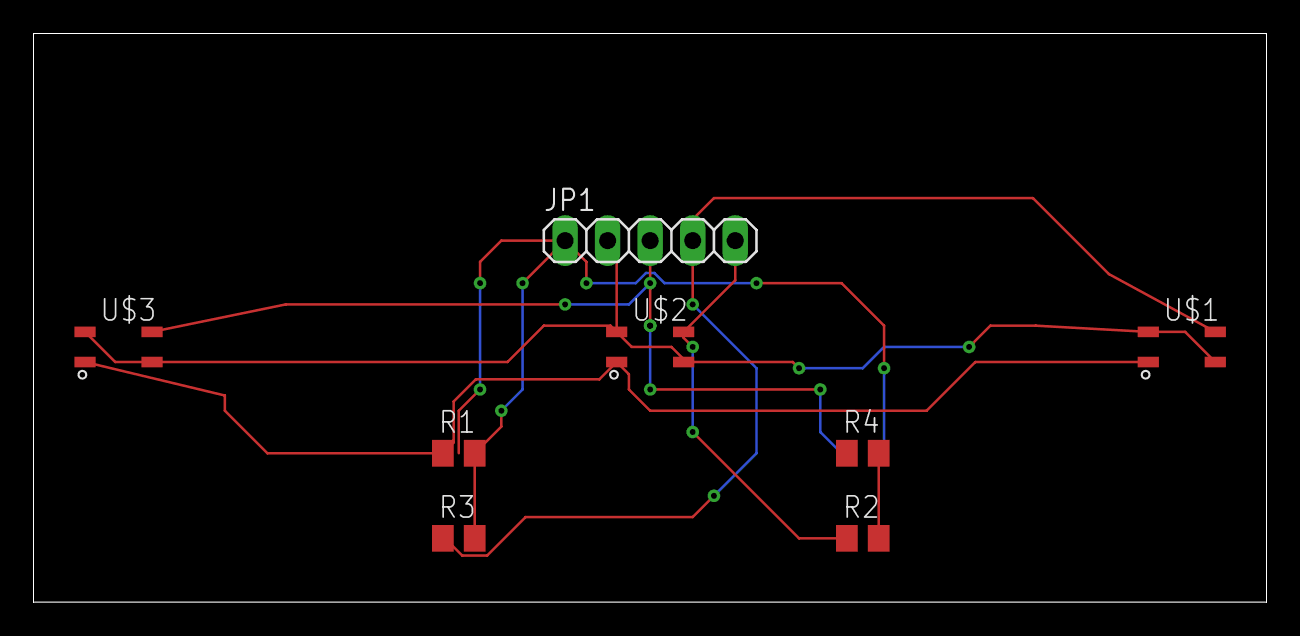
[picture p73: board IRBumper_AB.brd from above]

Board: 2 copper layers, 73.6 x 34.0 mm, 8 parts (0 on the bottom side), 6 nets.
